Trickky337/arduino-curve-tracer/hardware/curve_tracer/curve_tracer.pdf

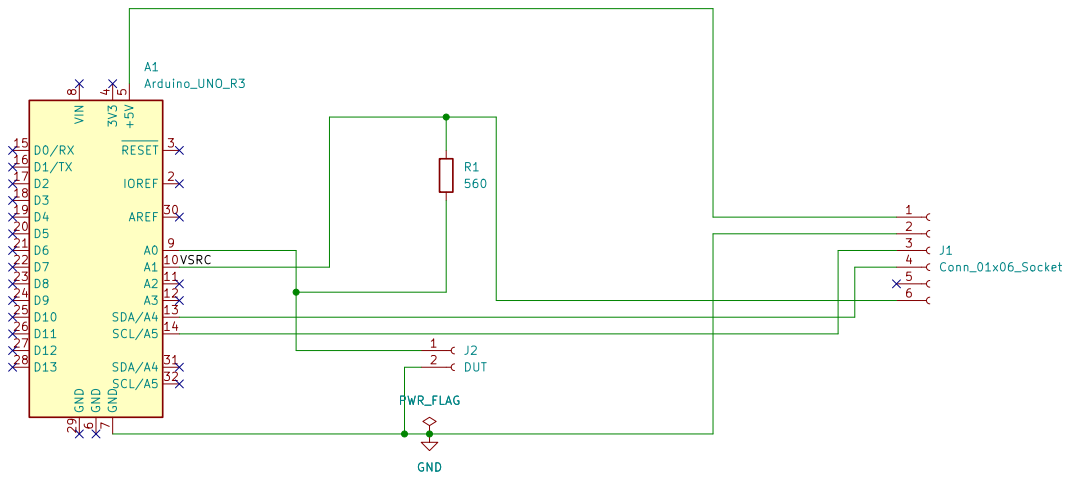
[picture p8: page 1]

Size: A4 | Rev: 1.0
KiCad E.D.A. 10.0.7 | Id: 1/1
