Trickky337/arduino-curve-tracer/hardware/curve_tracer/curve_tracer.kicad_pcb

## KiCad design world_datr.kicad_sch

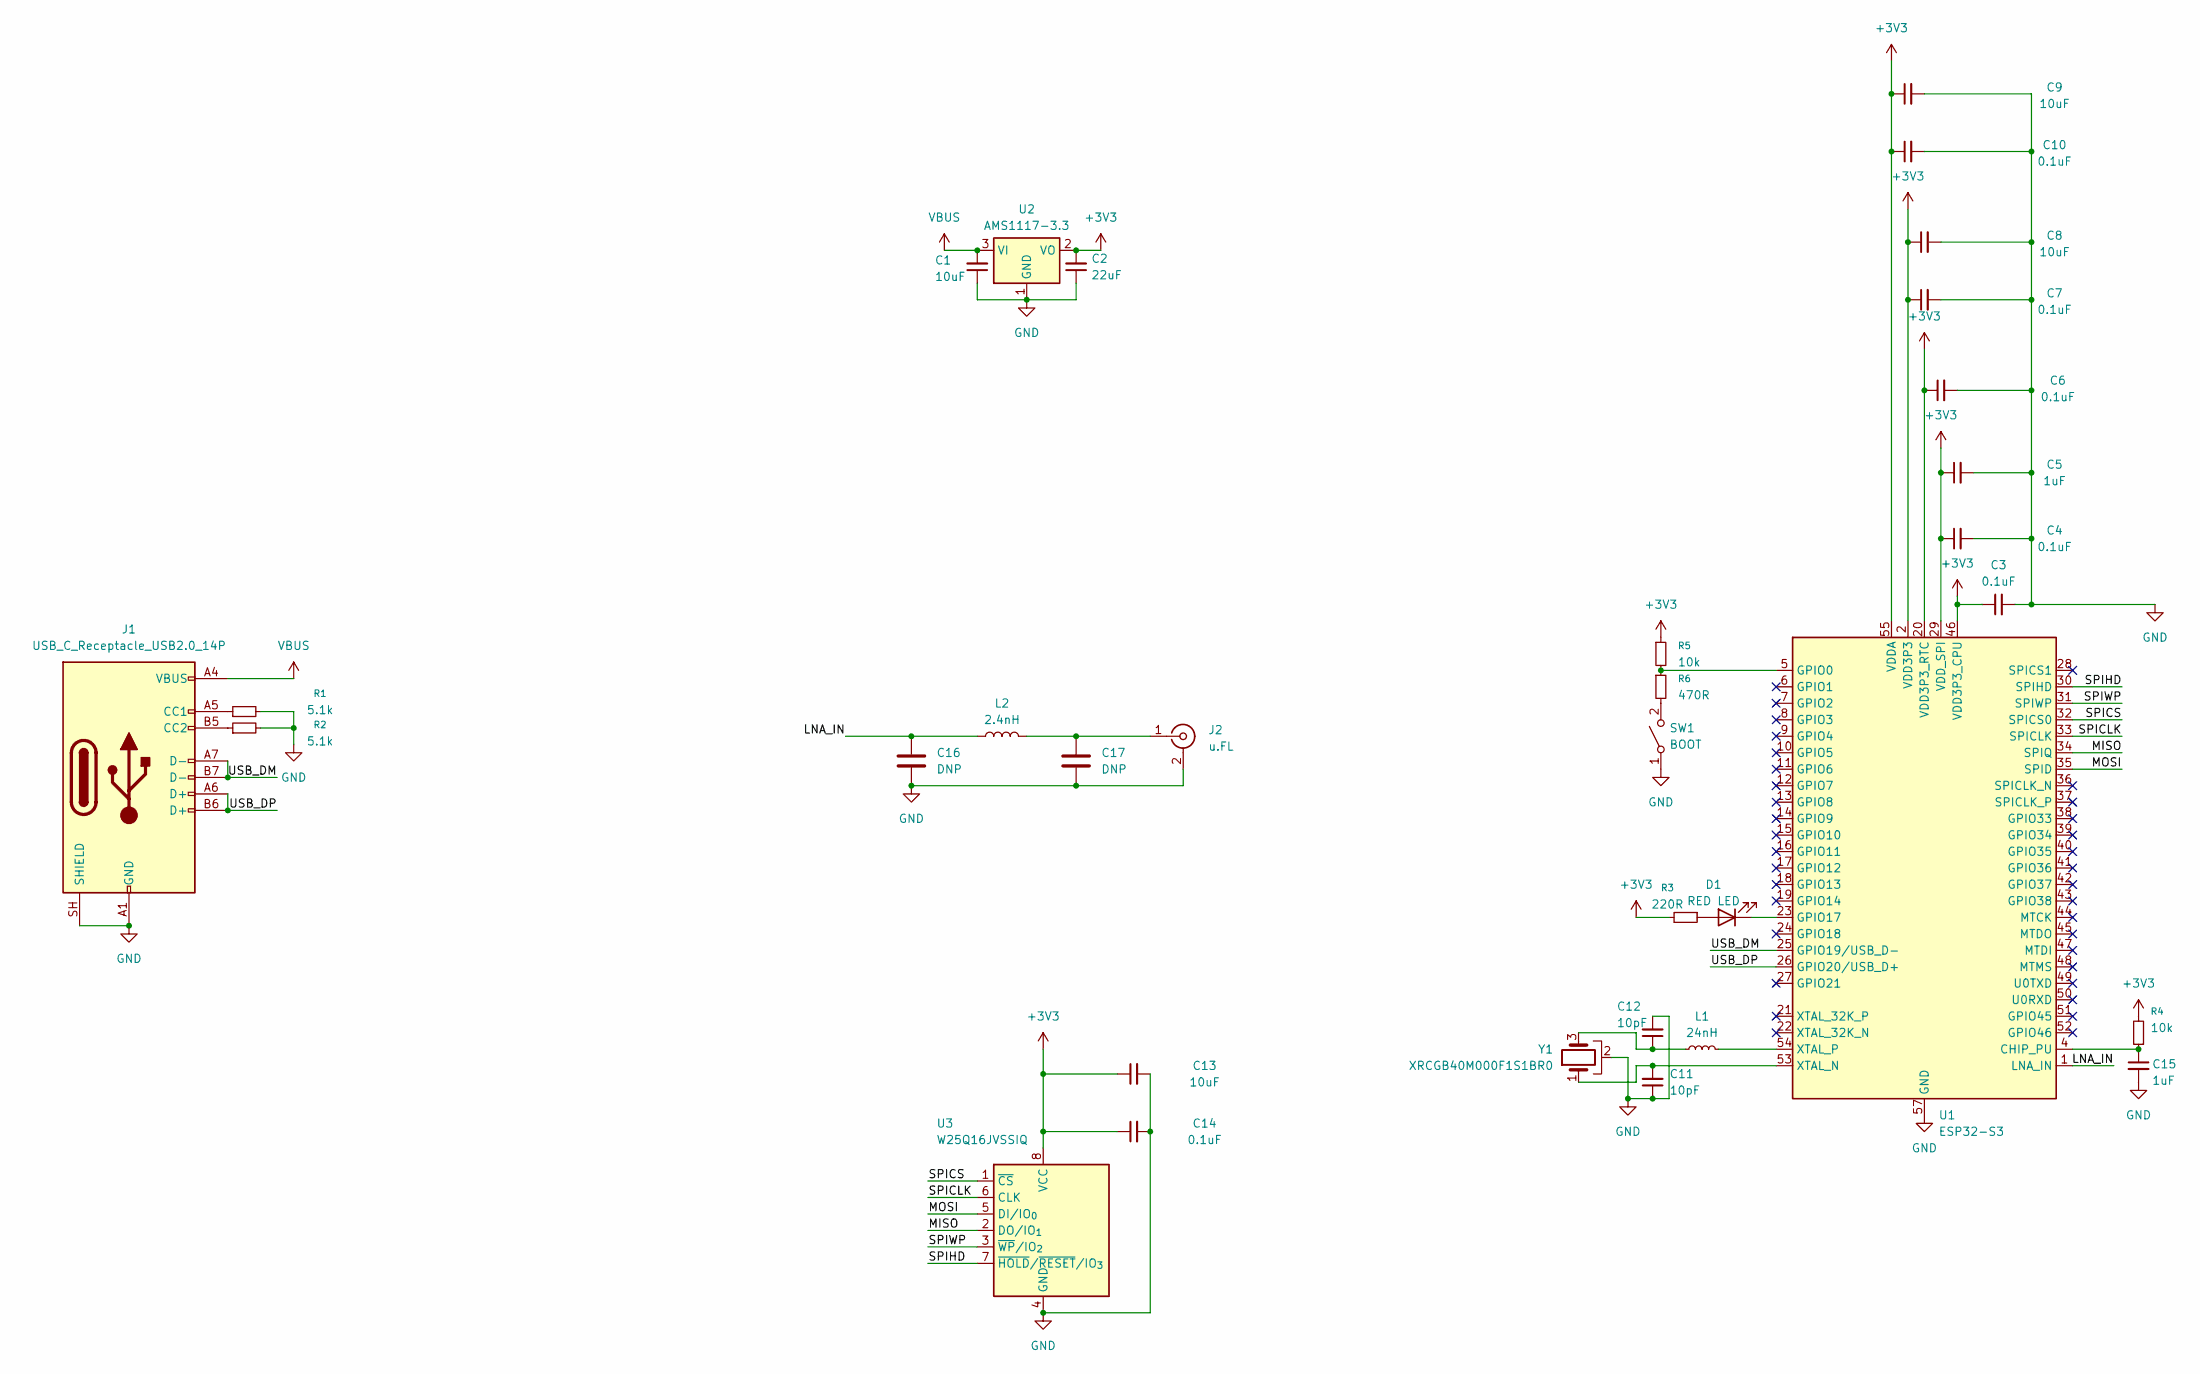
[picture p9: schematic world_datr.kicad_sch]

Parts:
C1, C8, C9, C13: 10uF
C2: 22uF
C3, C4, C6, C7, C10, C14: 0.1uF
C5, C15: 1uF
C11, C12: 10pF
C16, C17: DNP
D1: RED LED
J1: USB_C_Receptacle_USB2.0_14P
J2: u.FL
L1: 24nH
L2: 2.4nH
R1, R2: 5.1k
R3: 220R
R4, R5: 10k
R6: 470R
SW1: BOOT
U1: ESP32-S3; QFN-56-1EP_7x7mm_P0.4mm_EP4x4mm
U2: AMS1117-3.3; SOT-223-3_TabPin2
U3: W25Q16JVSSIQ; SOIC-8_5.3x5.3mm_P1.27mm
Y1: XRCGB40M000F1S1BR0

Connections:
+3V3: C2.2, C3.1, C4.1, C5.1, C6.1, C7.1, C8.1, C9.1, C10.1, C13.1, C14.1, R3.2, R4.2, R5.1, U1.2 (VDD3P3), U1.3 (VDD3P3), U1.20 (VDD3P3_RTC), U1.29 (VDD_SPI), U1.46 (VDD3P3_CPU), U1.55 (VDDA), U1.56 (VDDA), U2.2 (VO), U3.8 (VCC)
GND: C1.1, C2.1, C3.2, C4.2, C5.2, C6.2, C7.2, C8.2, C9.2, C10.2, C11.1, C12.2, C13.2, C14.2, C15.2, C16.2, C17.2, J1.A1 (GND), J1.A12 (GND), J1.B1 (GND), J1.B12 (GND), J1.SH (SHIELD), J2.2 (Ext), R1.2, R2.2, SW1.1 (A), U1.57 (GND), U2.1 (GND), U3.4 (GND), Y1.2
LNA_IN: C16.1, L2.1, U1.1 (LNA_IN)
MISO: U1.34 (SPIQ), U3.2 (DO/IO_{1})
MOSI: U1.35 (SPID), U3.5 (DI/IO_{0})
unnamed: C11.2, U1.53 (XTAL_N), Y1.1
unnamed: C12.1, L1.1, Y1.3
unnamed: C15.1, R4.1, U1.4 (CHIP_PU)
unnamed: C17.1, J2.1 (In), L2.2
unnamed: D1.1 (K), U1.23 (GPIO17)
unnamed: D1.2 (A), R3.1
unnamed: J1.A5 (CC1), R1.1
unnamed: J1.B5 (CC2), R2.1
unnamed: L1.2, U1.54 (XTAL_P)
unnamed: R5.2, R6.1, U1.5 (GPIO0)
unnamed: R6.2, SW1.2 (B)
SPICLK: U1.33 (SPICLK), U3.6 (CLK)
SPICS: U1.32 (SPICS0), U3.1 (~CS)
SPIHD: U1.30 (SPIHD), U3.7 (~HOLD/~RESET/IO_{3})
SPIWP: U1.31 (SPIWP), U3.3 (~WP/IO_{2})
USB_DM: J1.A7 (D-), J1.B7 (D-), U1.25 (GPIO19/USB_D-)
USB_DP: J1.A6 (D+), J1.B6 (D+), U1.26 (GPIO20/USB_D+)
VBUS: C1.2, J1.A4 (VBUS), J1.A9 (VBUS), J1.B4 (VBUS), J1.B9 (VBUS), U2.3 (VI)
