Trickky337/arduino-curve-tracer/(commit log)

2026-10-09 Enhance README with project details and roadmap
    Added detailed project information and roadmap for the Arduino Curve Tracer.
2026-10-14 Add curve tracer firmware, plotting script, and README (in development)
2026-10-16 Add first measured 1N4007 I-V sweep and fix plot script
    [1N4007.csv]
2026-10-16 Add repeatability runs and Shockley fit analysis script
    [1N4007_run1.csv, 1N4007_run2.csv, 1N4007_run3.csv]
2026-10-16 Add red LED repeatability runs and analysis
    [LED_red_run1.csv, LED_red_run2.csv, LED_red_run3.csv]
2026-10-16 Update README with red LED results
2026-10-16 Add red LED test setup image to README
    Added image of the red LED test setup to the README.
2026-10-16 Update image filename for LED test setup
2026-10-16 Fix image filename case in README.md
2026-10-16 Update image file extension for LED setup
2026-10-16 Restore Red LED test setup image in README
    Reinsert the Red LED test setup image in the README.
2026-10-16 Remove duplicate LED setup photo
2026-10-16 Add KiCad schematic for the curve tracer (Phase A)
    [curve_tracer.kicad_pcb, curve_tracer.kicad_sch]
2026-10-20 Add test automation script and sample report (Phase D, offline mode)
